ChekoMkocheko/roboticrover/ConnectionToBattery.jpeg

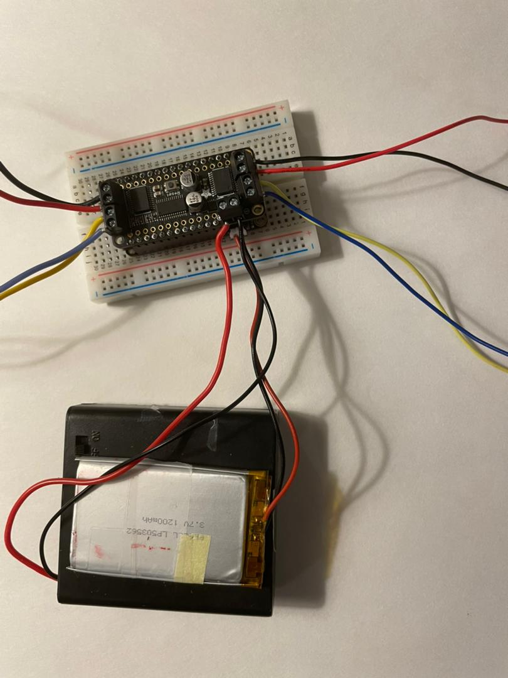
ConnectionToBattery.jpeg
