ChekoMkocheko/roboticrover/ConnectionToMotors.jpeg

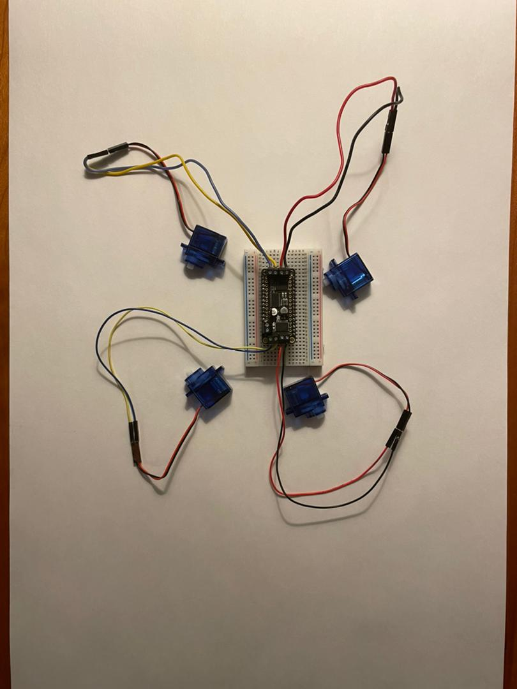
ConnectionToMotors.jpeg
