ChekoMkocheko/roboticrover/ConnectionToSensor.jpeg

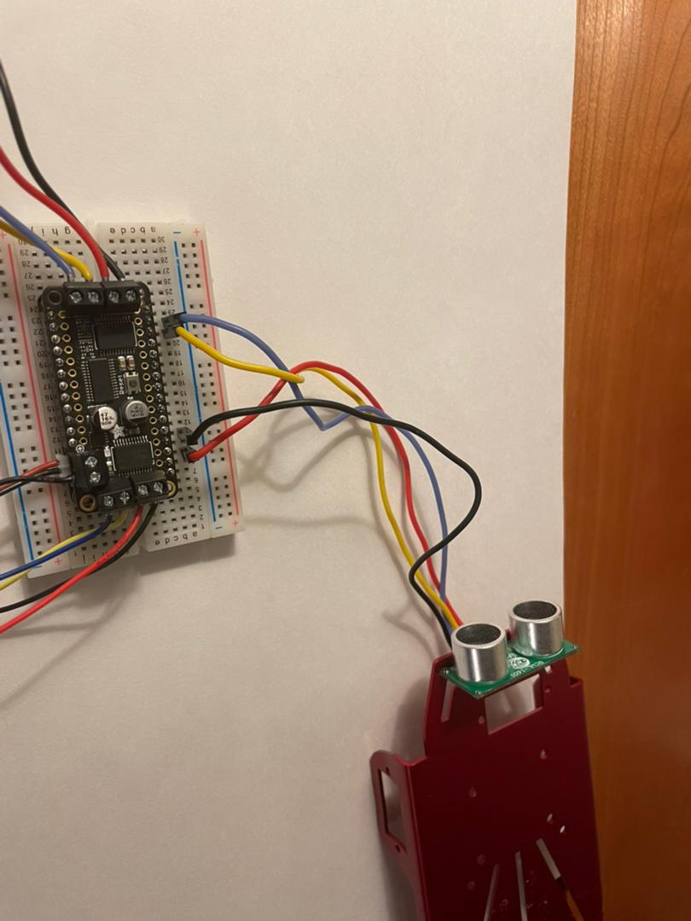
ConnectionToSensor.jpeg
