ChekoMkocheko/roboticrover/(commit log)

2021-12-01 Added code for utrasonic sensor
2021-12-08 Update README.md
    Added material, libraries and project description
2021-12-18 Added code that corrects distance when in autonomous mode
    [rover.ino]
2021-12-18 updated comments and readme
    I added more details about motor and how commands are received and interpreted via bluetooth app
2021-12-18 Update README.md
    I just added more details about bluetooth and the motors
2021-12-18 Update README.md
    A few edits on bluetooth and motors
2021-12-18 Update README.md
    Added wiring diagram
2021-12-19 Add files via upload
    Added Images showing how wires are connected
